lordlynn/WDA/Documentation/README.md

# PROJECT DOCUMENTATION

## WizFi360 Setup
	In order to use the WizFi360, the UART and WiFi settings must be updated. The WizFI360 folder contains WizFi360_Setup.pdf that has basic instructions for setting up the board. There is also a copy of the firmware version required for this project. The firmware can also be found on the WizFi360 GitHub which is linked in the setup document. 

## MQTT Setup
	A MQTT broker is required to facilitate the wireless communication in this project. Within the MQTT folder there is a setup document that walks through the process of install and configuring the broker. 

## System documents
	The System folder has a block diagram, wiring diagram, bill of materials, and state machines.
