lordlynn/WDA/Documentation/System/CoreApplication_StateMachine.png

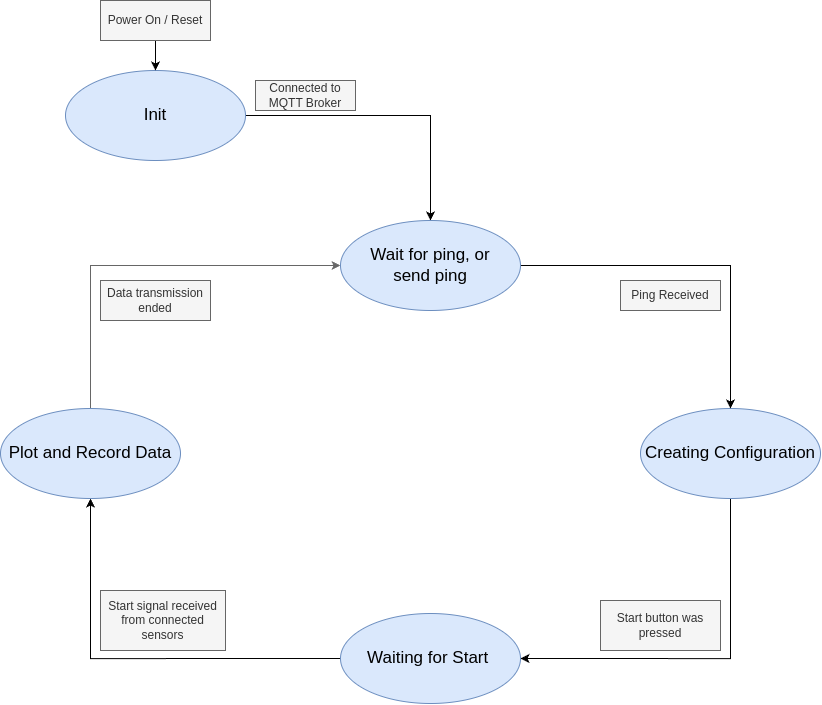
Documentation/System/CoreApplication_StateMachine.png
