lordlynn/WDA/Documentation/System/Embedded_StateMachine.png

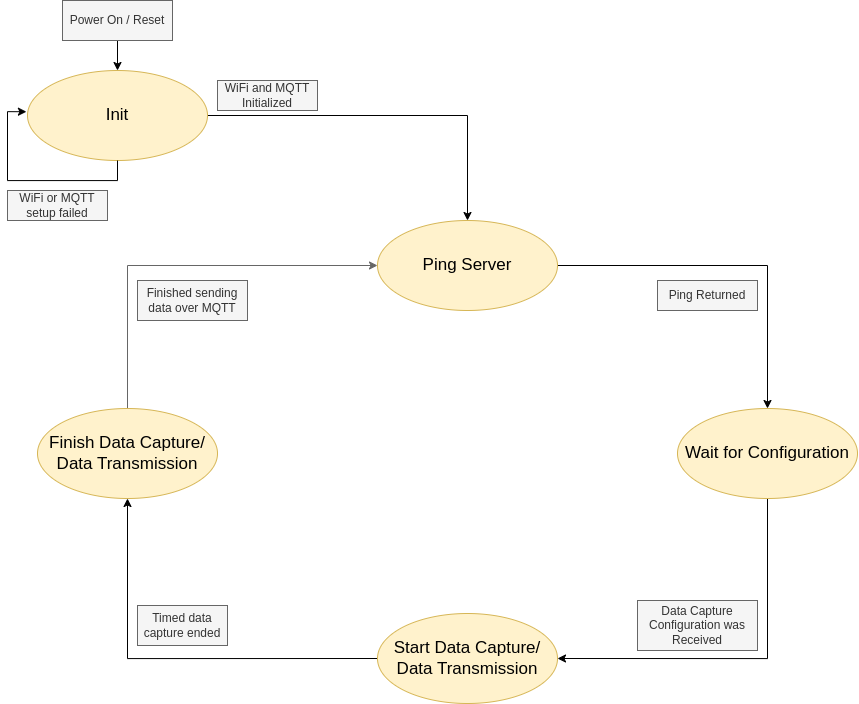
Documentation/System/Embedded_StateMachine.png
