lordlynn/WDA/Documentation/System/Hardware_BlockDiagram.png

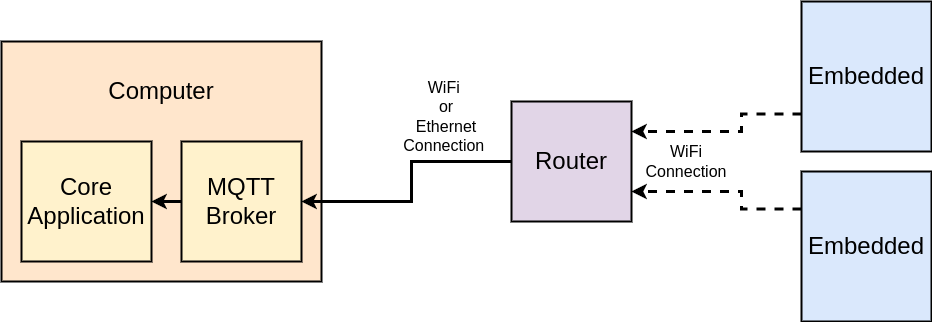
Documentation/System/Hardware_BlockDiagram.png
