lordlynn/WDA/Documentation/System/BillofMaterials.pdf

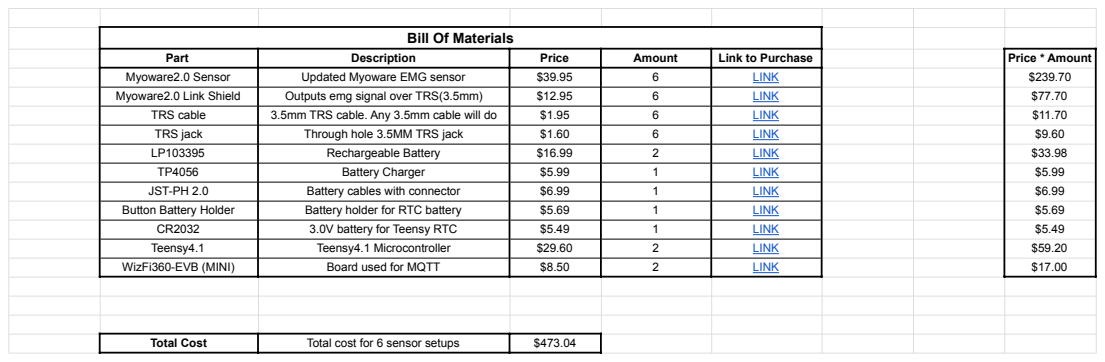
[picture p4: page 1]
Part; Description; Price; Amount; Link to Purchase; Price * Amount; Myoware2.0 Sensor; Updated Myoware EMG sensor; LINK; Myoware2.0 Link Shield; Outputs emg signal over TRS(3.5mm); TRS cable; 3.5mm TRS cable. Any 3.5mm cable will do; TRS jack; Through hole 3.5MM TRS jack; Rechargeable Battery; Battery Charger; JST-PH 2.0; Battery cables with connector; Button Battery Holder; Battery holder for RTC battery; 3.0V battery for Teensy RTC; Teensy4.1; Teensy4.1 Microcontroller; WizFi360-EVB (MINI)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

Bill Of Materials
