lordlynn/WDA/Documentation/WizFi360/WizFi360_Setup.pdf

# WizFi360 Quickstart Guide

## Configuration for MQTT

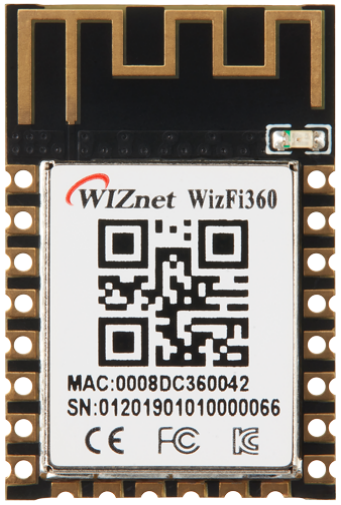
[picture p8: figure]

### Zac Lynn

3/6/2024

## Table of Contents

Table of Contents | 2
Connecting to the Board | 3
Figure 1: Setting Mode of Operation | 3
Updating the Firmware | 3
Connecting Board to WiFi | 4
Figure 2: Temporary AT Connection Configuration | 4
Figure 3: Connecting Board to WifFi Example | 5
Setting UART Speed | 5
Connecting to MQTT (Implemented in Code) | 6
Figure 4: Set MQTT Configuration | 6
Figure 5: Set Publish and Subscribe Topics | 7
Figure 6: Connect To MQTT | 8

Lynn - 2

### Connecting to the Board

1.) Use a serial monitor application to connect to the board through USB. The default baud rate is 115200. The board also expects carriage returns and newlines at the end of inputs.
2.) To check the connection status type “AT” and wait for the “OK” message.
3.) Now, to connect to WiFi use the command AT+CWMODE_DEF to set the mode to station mode as shown in the WizFi documentation below.

AT+CWMODE_DEF=1

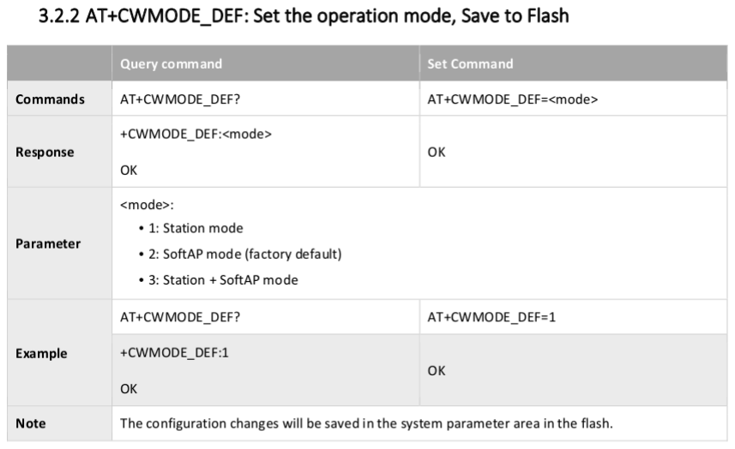
[picture p9: figure]

Figure 1: Setting Mode of Operation

### Updating the Firmware

For the code to work correctly the firmware may need to be updated to AT version 1.1.2.0. Use the AT command AT+GMR to check the current version; if the AT firmware is not at least 1.1.2.0 it will have to be updated. You can download the firmware from the link below. https://github.com/wizfi/Release/tree/master/Binary/1.1.2.0

Use the tutorial found at the link below to update the firmware. https://wizfi.github.io/Document/docs/basic_guides/firmware_upgrade#:~:text=Update%20Firmw are%20by%20communicating%20with%20Upgrade%20Tool%20through%20Wi%2DFi,is%20us ed%20UART0%20or%20UART1 (https://wizfi.github.io/Document/docs/basic_guides/firmware_upgrade)

### Connecting Board to WiFi

1.) Begin by polling the board for available networks using the command: AT+CWLAP a.) This command may need to be run a few times to see every available network

2.) Now to connect to your network use the command AT+CWJAP_CUR according to the data sheet shown below in Figure 2.

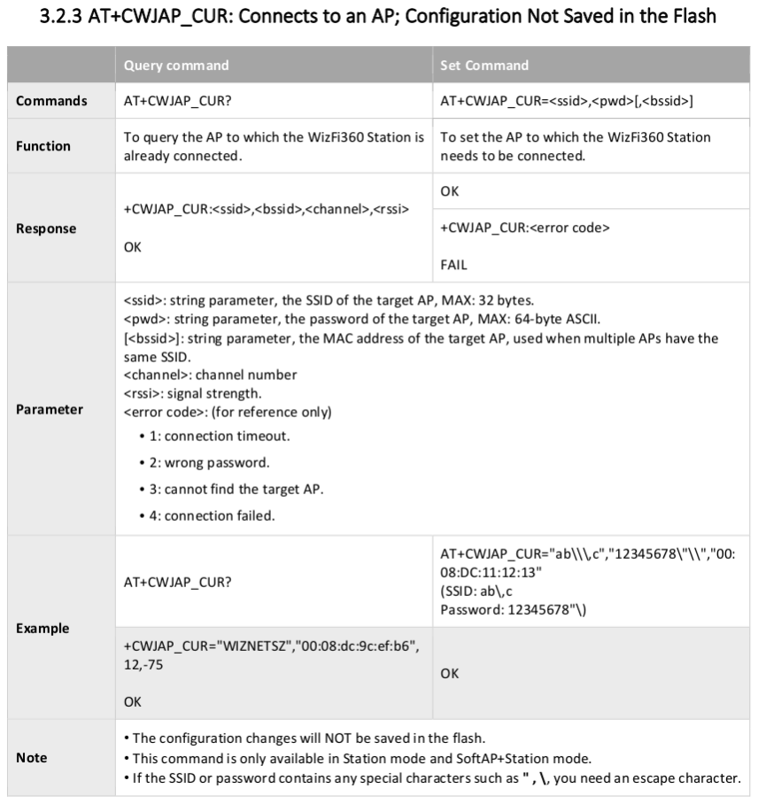
[picture p10: figure]

Figure 2: Temporary AT Connection Configuration

Figure 3 shows an example of connecting to a WiFi network. The portion that is covered is where you put the password. The password should be in double quotes.

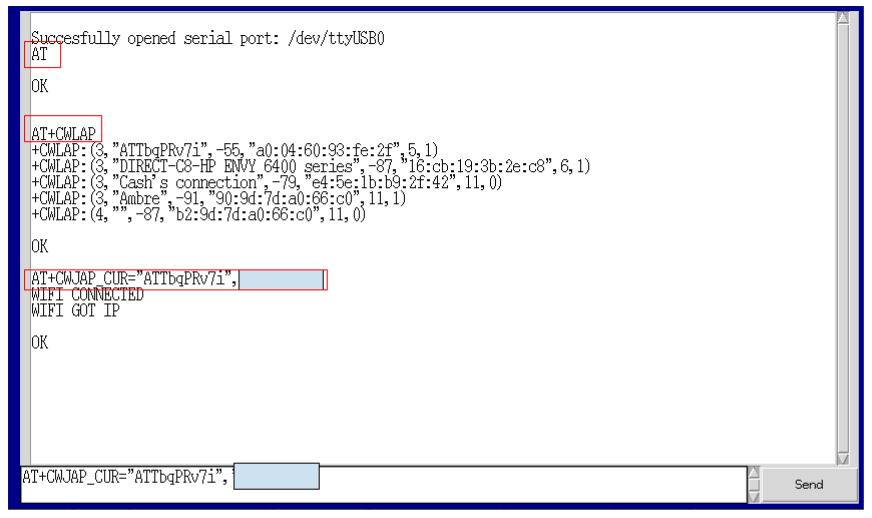
[picture p11: figure]

Figure 3: Connecting Board to WiFi Example

Here the network name and password are entered in double quotes separated by a comma.

3.) If the connection from step 2 was successful, the configuration can be saved into flash memory to persist through power cycles using the AT+CWJAP_DEF. The format of the command is the exact same as AT+CWJAP_CUR.

4.) To check the connection, remove power from the board and reconnect it. Then use the command “AT+CWJAP_CUR?” and or “AT+CWJAP_DEF?” to verify that the configuration has remained through power cycling.

### Setting UART Speed

1.) The baud rate must be increased to match the expected baud rate in the code. To change the baud rate use the command AT+UART_DEF as shown below.

AT+UART_DEF=1500000,8,1,0,0

Note that after changing the baud rate, you must update the baud rate in your serial monitor program in order to communicate with the WizFi360.

### Connecting to MQTT (Implemented in Code)

The initialization sequence used in the code uses three commands which are described below.

1.) Use the AT+MQTTSET command to configure the connection

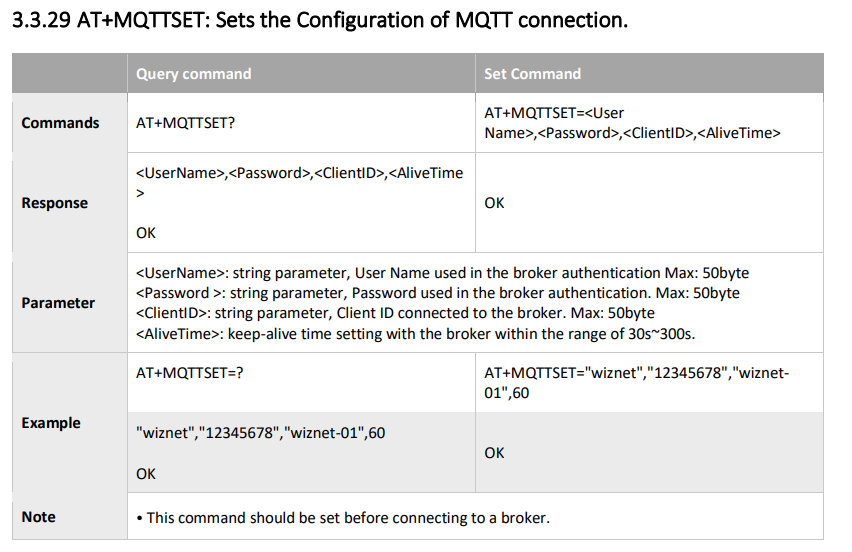
[picture p12: figure]

Figure 4: Set MQTT Configuration

2.) Use the AT+MQTTOPIC command to set a topic to publish to and topics to subscribe to

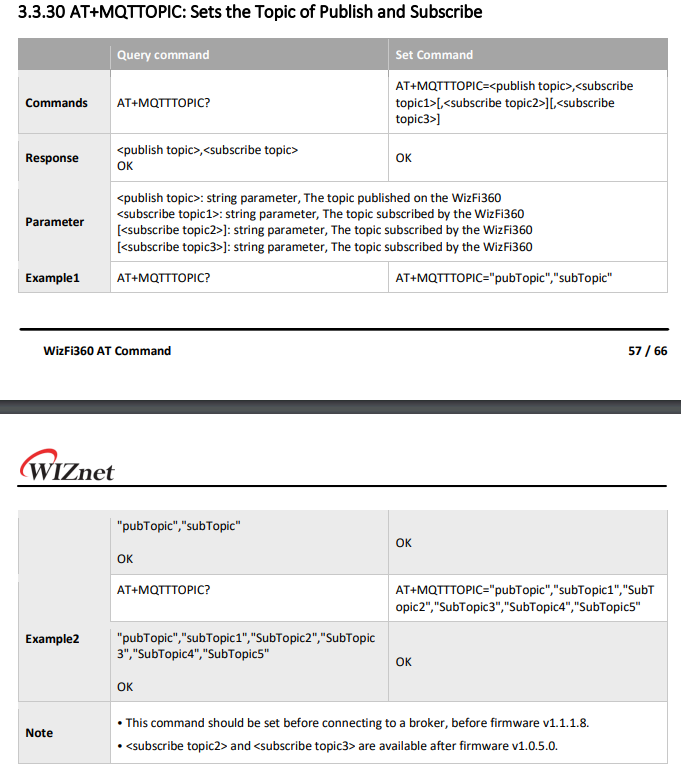
[picture p13: figure]

Figure 5: Set Publish and Subscribe Topics

3.) Use the AT+MQTTCON command to connect to a broker

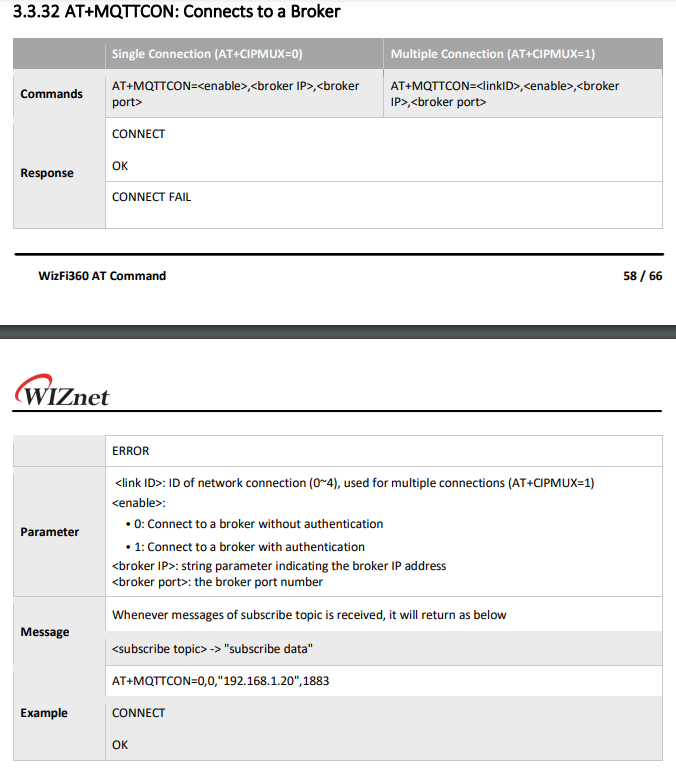
[picture p14: figure]

Figure 6: Connect To MQTT

Use the AT+MQTTQOS command to set the quality of service of publishes (Rx is always QOS 0).
