lordlynn/WDA/Documentation/System/wiringDiagram.png

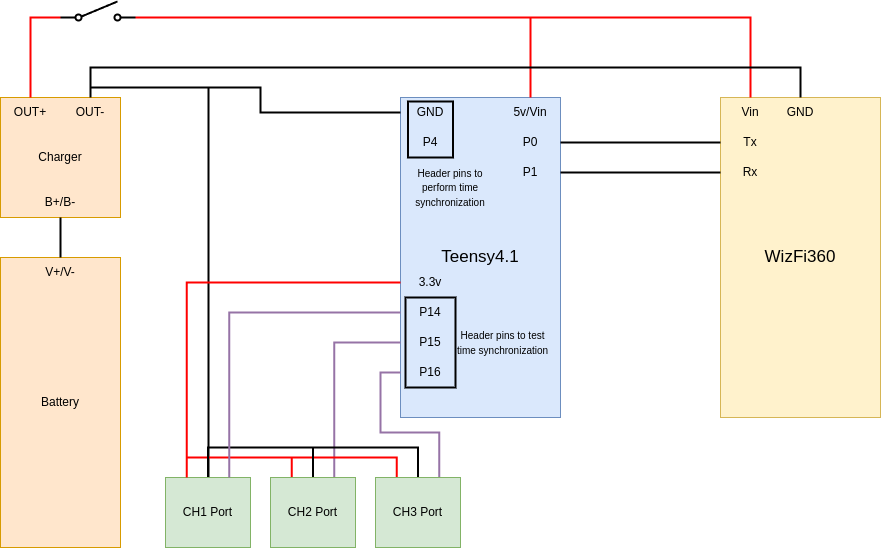
Documentation/System/wiringDiagram.png
