lordlynn/WDA/(commit log)

2024-10-21 Modified so that it uses the current directory to find the config file.
2024-11-11 Added Arduino IDE version of embedded code. Continous improvement.
    [TestResults.xlsx]
2024-11-13 Increased baud rate from teensy4.1 to WizFi360 from 1M to 1.5M
    [TestResults.xlsx]
2024-11-13 Remove testing excel sheet from repository
    [TestResults.xlsx]
2025-04-20 Added comments, fixed some weird stuff with repititious varibles in coreApplication/MQTT
    [dataBuffer.cpp, dataBuffer.h]
2025-04-21 Added some comments to core app. split some function in MQTT. fixed ping/pong
    [MQTT.cpp]
